knielsen/pcb_pov3d/README

PCB for 3D POV based on STM32F405 MCU and TLC5955 LED driver.
