knielsen/pcb_pov3d/pcb_pov3d.kicad_pcb

## KiCad design pcb_pov3d.kicad_pcb (2015-05-03)

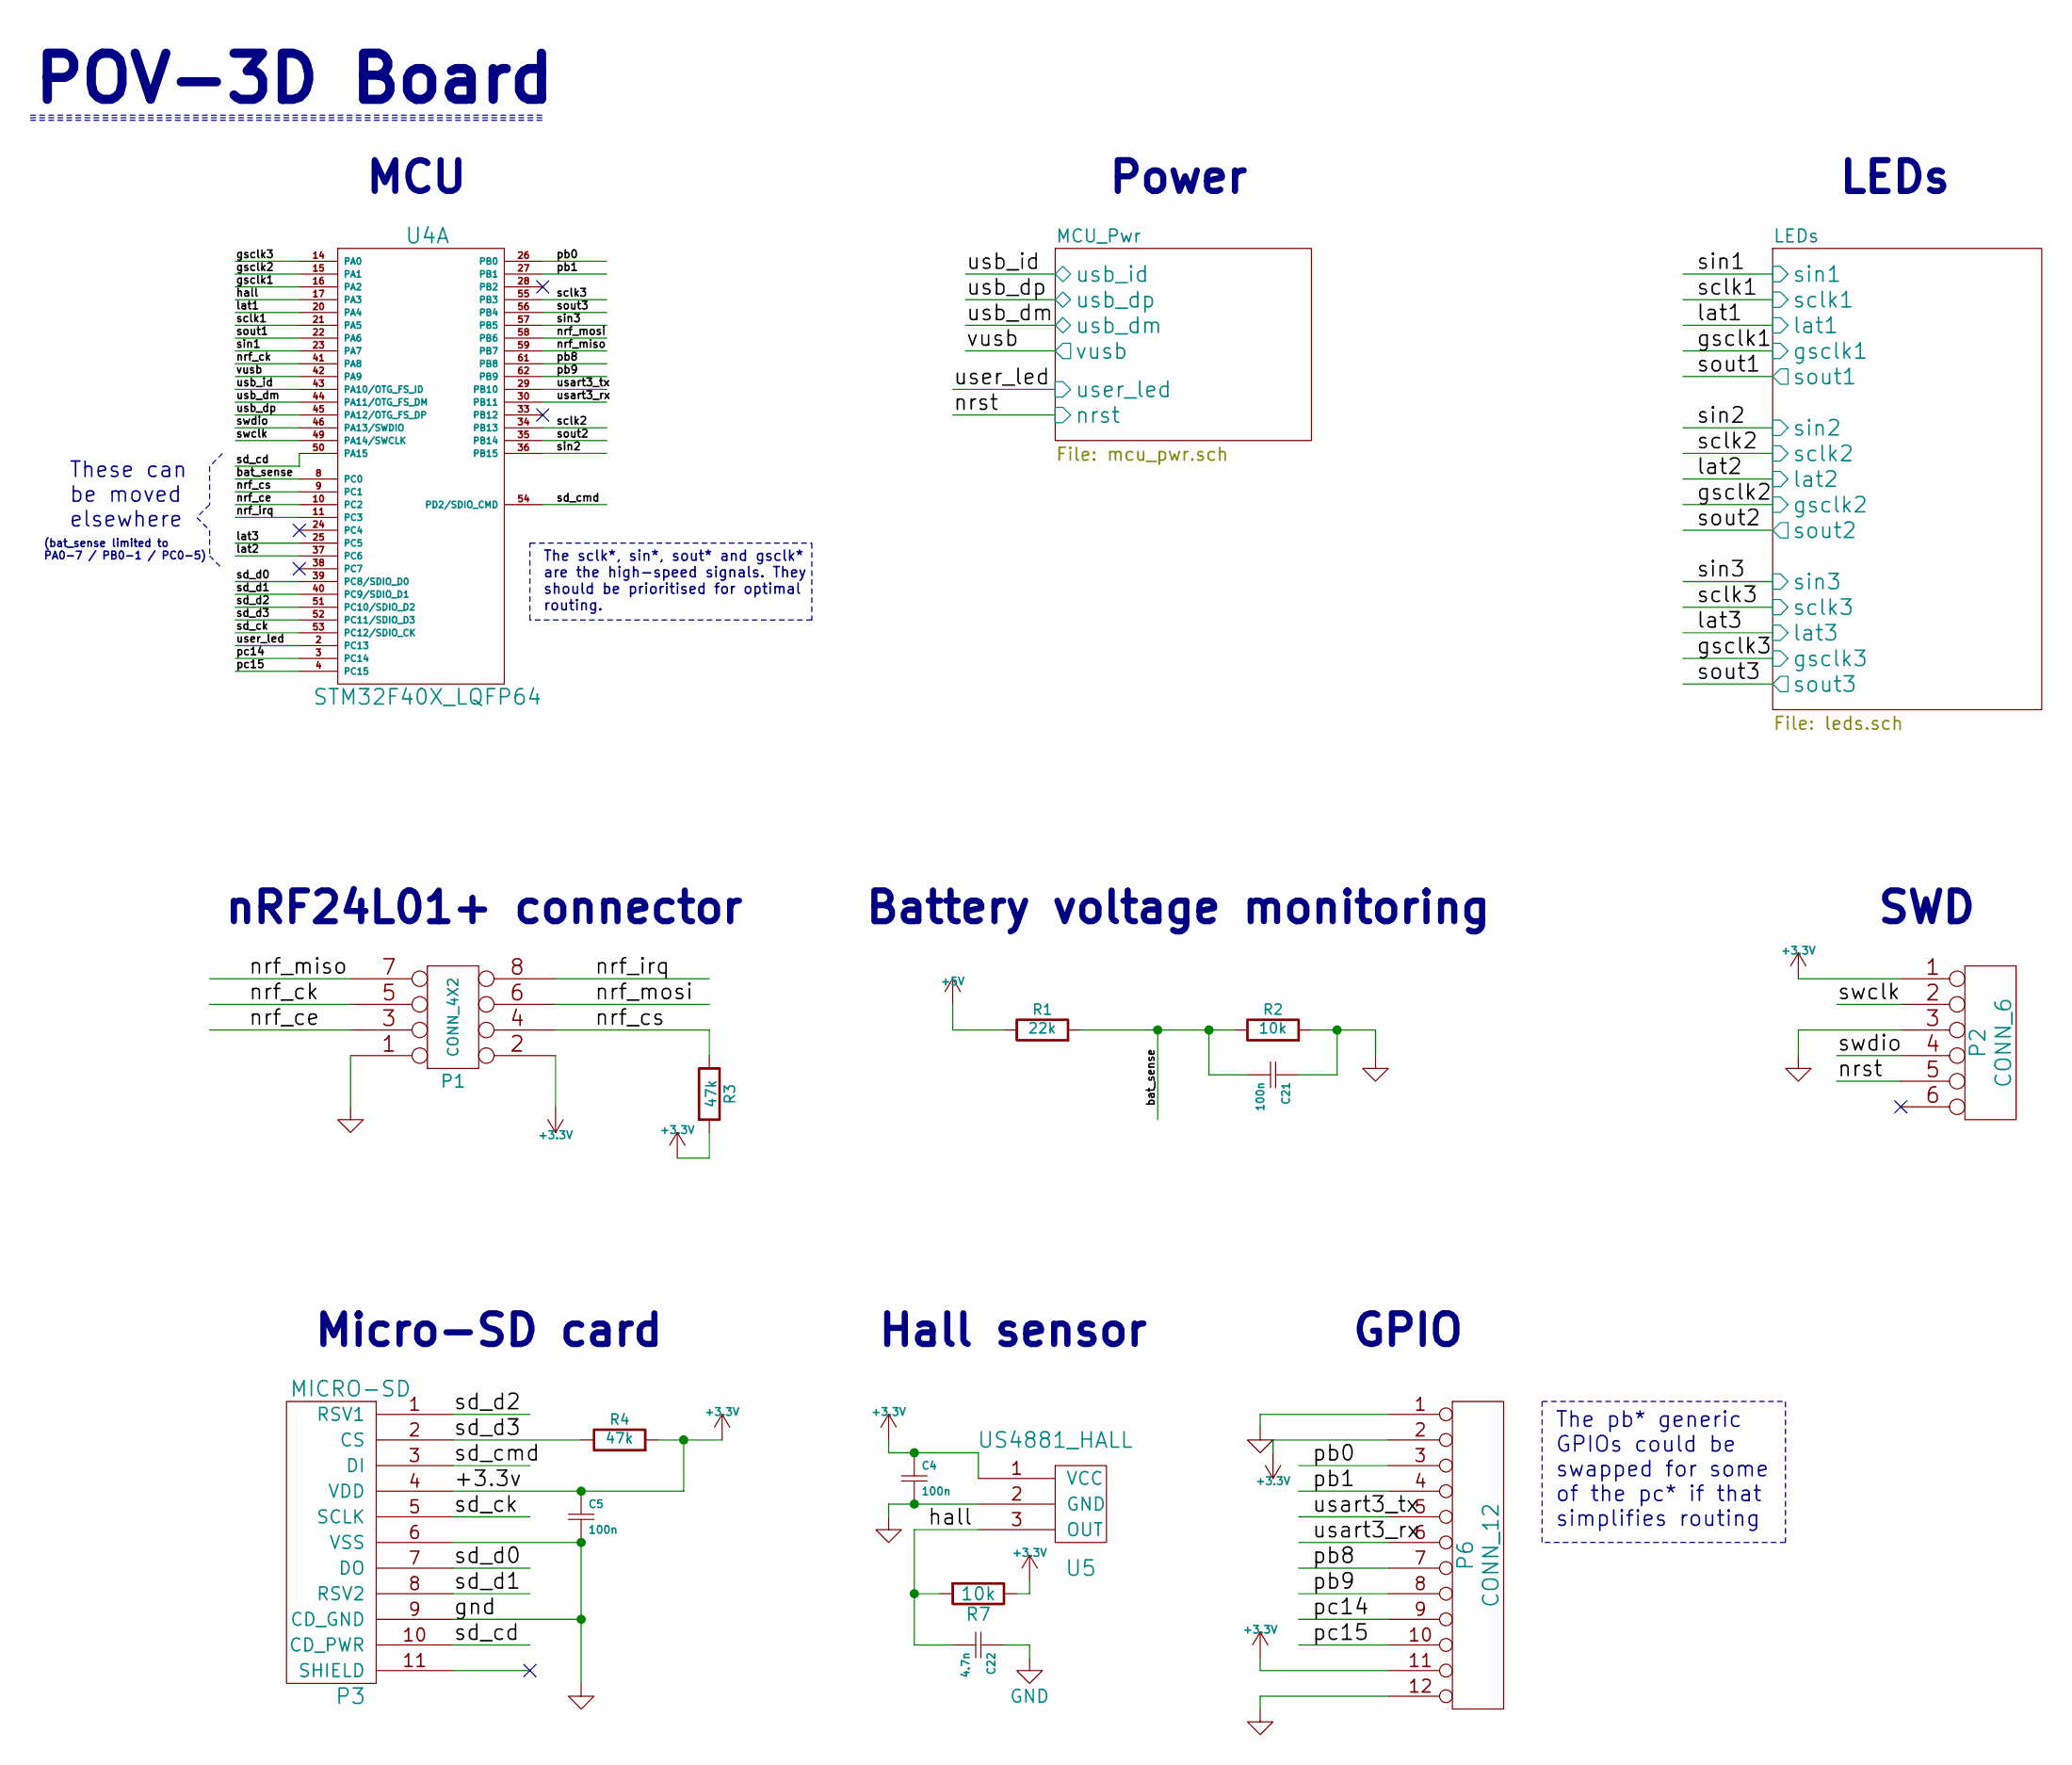
[picture p1: schematic pcb_pov3d.sch]

Parts:
C4, C5, C21: 100n; c_0805
C22: 4.7n; c_0805
P1: CONN_4X2; pin_socket_4x2
P2: CONN_6; pin_strip_6
P3: MICRO-SD; SD_502774
P6: CONN_12; pin_strip_12-90
R1: 22k; r_0805
R2, R7: 10k; r_0805
R3, R4: 47k; r_0805
U4: STM32F40X_LQFP64; LQFP_64
U5: US4881_HALL; TO92

Connections:
+3V3: C4.1, C5.1, P1.2, P2.1, P3.4 (VDD), P6.2, P6.11, R3.2, R4.2, R7.1, U5.1 (VCC); also elsewhere on the board
+5V: R1.1; also elsewhere on the board
/LEDs/gsclk1: U4.16 (PA2); also elsewhere on the board
/LEDs/gsclk2: U4.15 (PA1); also elsewhere on the board
/LEDs/gsclk3: U4.14 (PA0); also elsewhere on the board
/LEDs/lat1: U4.20 (PA4); also elsewhere on the board
/LEDs/lat2: U4.37 (PC6); also elsewhere on the board
/LEDs/lat3: U4.25 (PC5); also elsewhere on the board
/LEDs/sclk1: U4.21 (PA5); also elsewhere on the board
/LEDs/sclk2: U4.34 (PB13); also elsewhere on the board
/LEDs/sclk3: U4.55 (PB3); also elsewhere on the board
/LEDs/sin1: U4.23 (PA7); also elsewhere on the board
/LEDs/sin2: U4.36 (PB15); also elsewhere on the board
/LEDs/sin3: U4.57 (PB5); also elsewhere on the board
/LEDs/sout1: U4.22 (PA6); also elsewhere on the board
/LEDs/sout2: U4.35 (PB14); also elsewhere on the board
/LEDs/sout3: U4.56 (PB4); also elsewhere on the board
/MCU_Pwr/nrst: P2.5; also elsewhere on the board
/MCU_Pwr/usb_dm: U4.44 (PA11/OTG_FS_DM); also elsewhere on the board
/MCU_Pwr/usb_dp: U4.45 (PA12/OTG_FS_DP); also elsewhere on the board
/MCU_Pwr/usb_id: U4.43 (PA10/OTG_FS_ID); also elsewhere on the board
/MCU_Pwr/user_led: U4.2 (PC13); also elsewhere on the board
/MCU_Pwr/vusb: U4.42 (PA9); also elsewhere on the board
/bat_sense: C21.2, R1.2, R2.1, U4.8 (PC0)
/hall: C22.2, R7.2, U4.17 (PA3), U5.3 (OUT)
/nrf_ce: P1.3, U4.10 (PC2)
/nrf_ck: P1.5, U4.41 (PA8)
/nrf_cs: P1.4, R3.1, U4.9 (PC1)
/nrf_irq: P1.8, U4.11 (PC3)
/nrf_miso: P1.7, U4.59 (PB7)
/nrf_mosi: P1.6, U4.58 (PB6)
/pb0: P6.3, U4.26 (PB0)
/pb1: P6.4, U4.27 (PB1)
/pb8: P6.7, U4.61 (PB8)
/pb9: P6.8, U4.62 (PB9)
/pc14: P6.9, U4.3 (PC14)
/pc15: P6.10, U4.4 (PC15)
/sd_cd: P3.10 (CD_PWR), U4.50 (PA15)
/sd_ck: P3.5 (SCLK), U4.53 (PC12/SDIO_CK)
/sd_cmd: P3.3 (DI), U4.54 (PD2/SDIO_CMD)
/sd_d0: P3.7 (DO), U4.39 (PC8/SDIO_D0)
/sd_d1: P3.8 (RSV2), U4.40 (PC9/SDIO_D1)
/sd_d2: P3.1 (RSV1), U4.51 (PC10/SDIO_D2)
/sd_d3: P3.2 (CS), R4.1, U4.52 (PC11/SDIO_D3)
/swclk: P2.2, U4.49 (PA14/SWCLK)
/swdio: P2.4, U4.46 (PA13/SWDIO)
/usart3_rx: P6.6, U4.30 (PB11)
/usart3_tx: P6.5, U4.29 (PB10)
GND: C4.2, C5.2, C21.1, C22.1, P1.1, P2.3, P3.6 (VSS), P3.9 (CD_GND), P6.1, P6.12, R2.2, U5.2 (GND); also elsewhere on the board

Notes on the sheet:
nRF24L01+ connector
MCU
Micro-SD card
These can be moved elsewhere
(bat_sense limited to PA0-7 / PB0-1 / PC0-5)
Battery voltage monitoring
Power
LEDs
SWD
Hall sensor
GPIO
POV-3D Board
The sclk*, sin*, sout* and gsclk* are the high-speed signals. They should be prioritised for optimal routing.
The pb* generic GPIOs could be swapped for some of the pc* if that simplifies routing

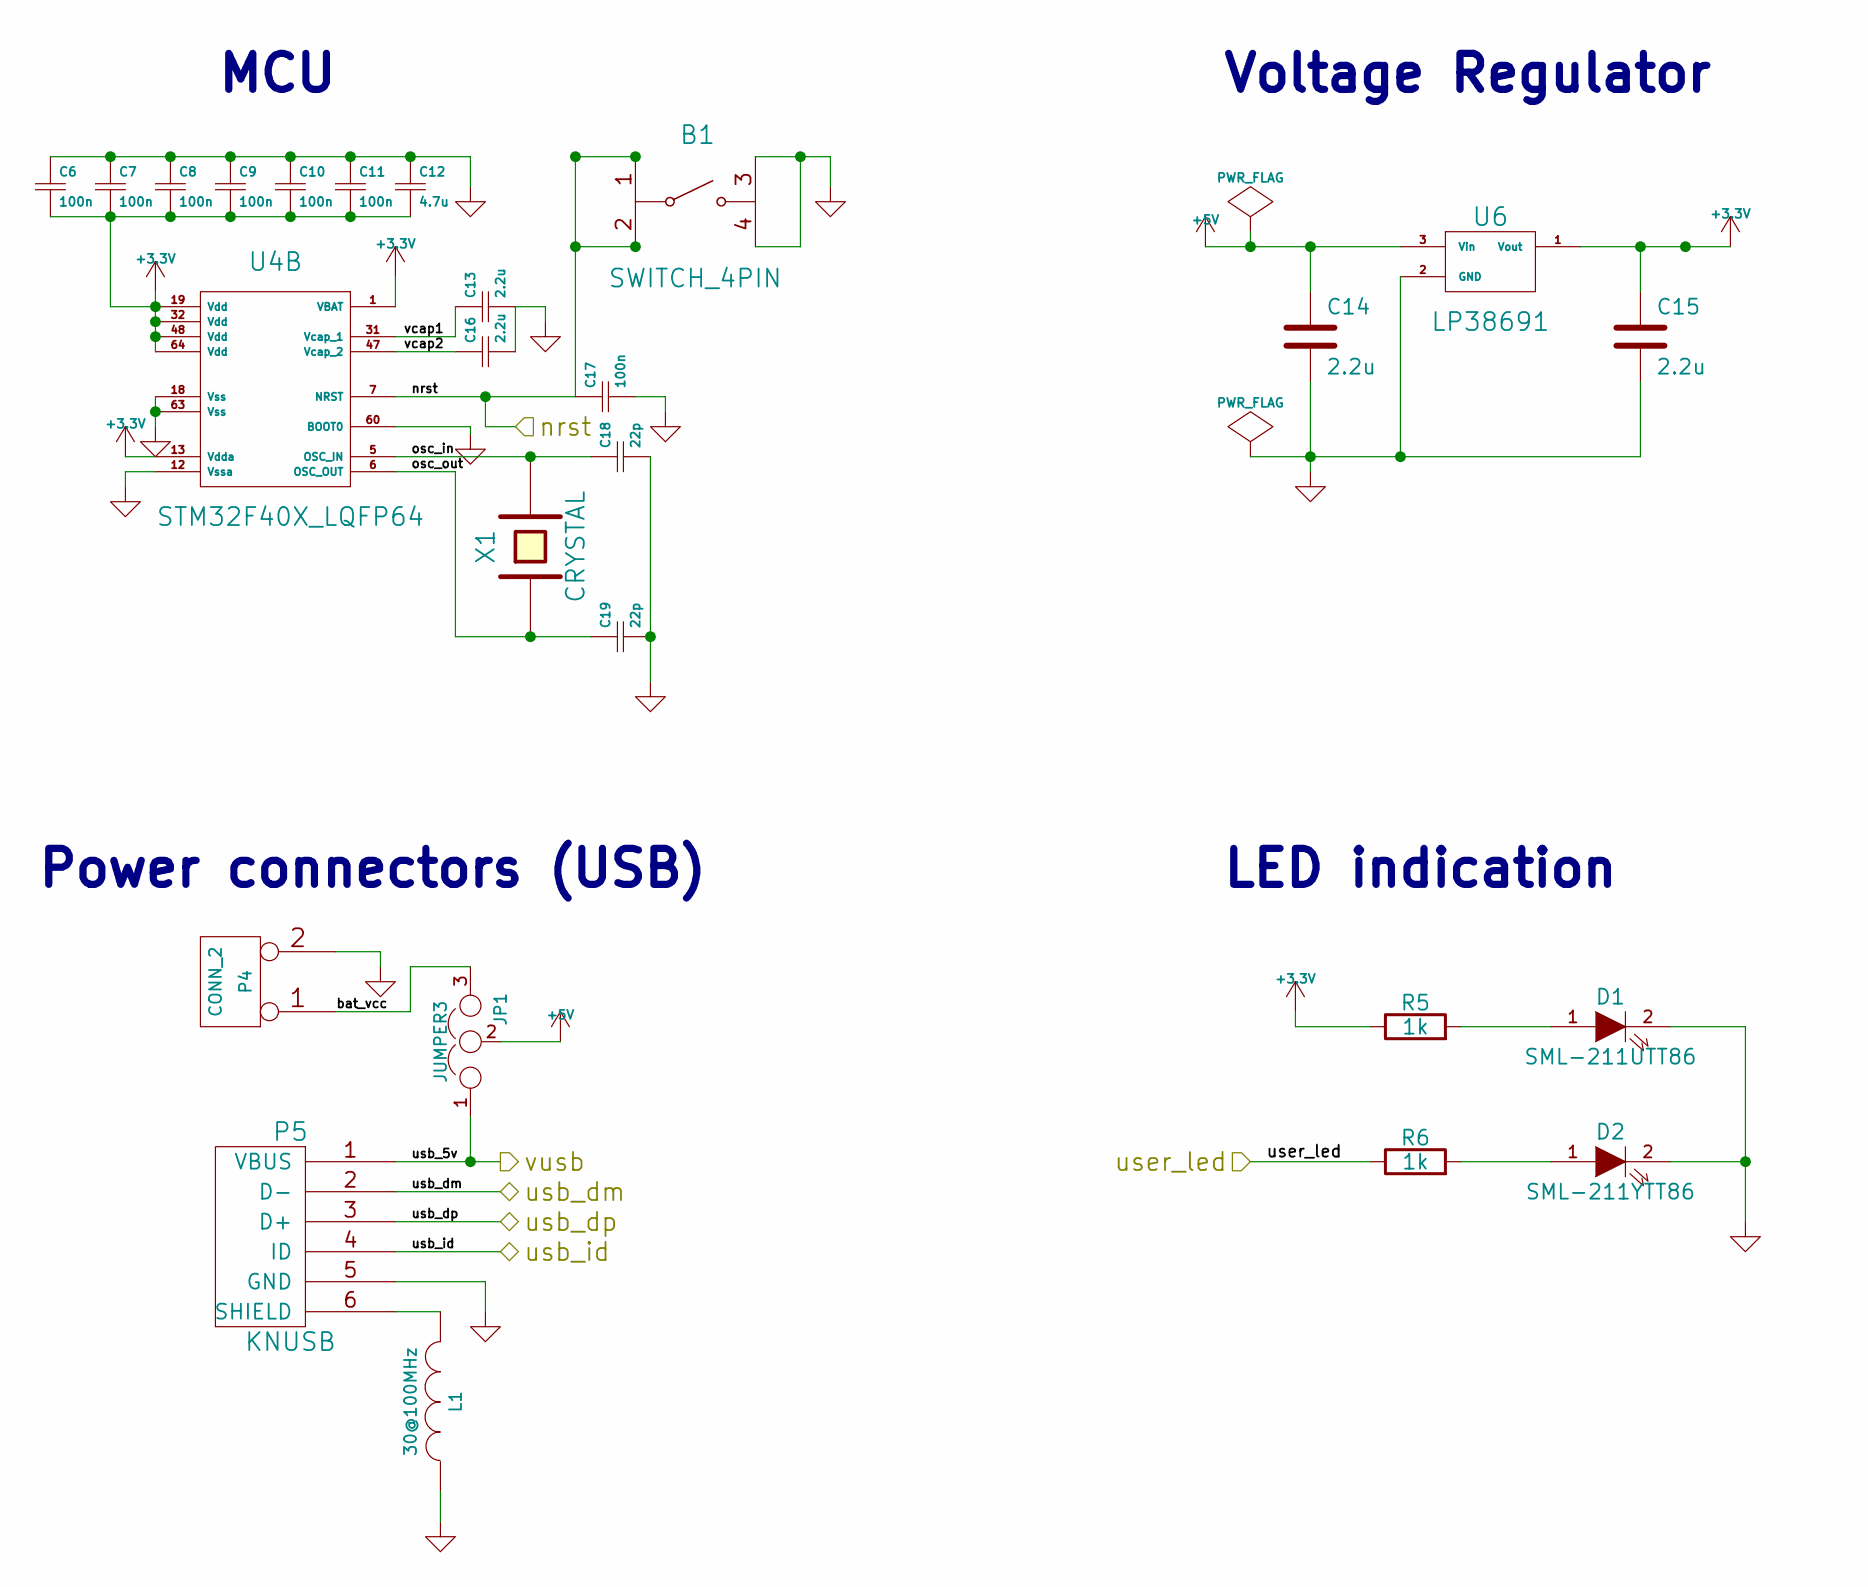
[picture p2: schematic mcu_pwr.sch]

Parts:
B1: SWITCH_4PIN; SWITCH_FSMJSMA
C6, C7, C8, C9, C10, C11, C17: 100n; c_0805
C12: 4.7u; c_0805
C13, C14, C15, C16: 2.2u; c_0805
C18, C19: 22p; c_0805
D1: SML-211UTT86; Led_0805
D2: SML-211YTT86; Led_0805
JP1: JUMPER3; pin_strip_3
L1: 30@100MHz; SMD-0603
P4: CONN_2; pin_strip_2-90
P5: KNUSB; 10103594-0001LF
R5, R6: 1k; r_0805
U4: STM32F40X_LQFP64; LQFP_64
U6: LP38691; TO-252-3
X1: CRYSTAL; 2-SOJ

Connections:
+3V3: C6.2, C7.2, C8.2, C9.2, C10.2, C11.2, C12.2, C15.1, R5.1, U4.1 (VBAT), U4.13 (Vdda), U4.19 (Vdd), U4.32 (Vdd), U4.48 (Vdd), U4.64 (Vdd), U6.1 (Vout); also elsewhere on the board
+5V: C14.1, JP1.2, U6.3 (Vin); also elsewhere on the board
/MCU_Pwr/bat_vcc: JP1.3, P4.1
/MCU_Pwr/nrst: B1.1, B1.2, C17.1, U4.7 (NRST); also elsewhere on the board
/MCU_Pwr/osc_in: C18.1, U4.5 (OSC_IN), X1.2
/MCU_Pwr/osc_out: C19.1, U4.6 (OSC_OUT), X1.1
/MCU_Pwr/usb_dm: P5.2 (D-); also elsewhere on the board
/MCU_Pwr/usb_dp: P5.3 (D+); also elsewhere on the board
/MCU_Pwr/usb_id: P5.4 (ID); also elsewhere on the board
/MCU_Pwr/user_led: R6.1; also elsewhere on the board
/MCU_Pwr/vcap1: C13.1, U4.31 (Vcap_1)
/MCU_Pwr/vcap2: C16.1, U4.47 (Vcap_2)
/MCU_Pwr/vusb: JP1.1, P5.1 (VBUS); also elsewhere on the board
GND: B1.3, B1.4, C6.1, C7.1, C8.1, C9.1, C10.1, C11.1, C12.1, C13.2, C14.2, C15.2, C16.2, C17.2, C18.2, C19.2, D1.2 (K), D2.2 (K), L1.1, P4.2 (PM), P5.5 (GND), U4.12 (Vssa), U4.18 (Vss), U4.60 (BOOT0), U4.63 (Vss), U6.2 (GND); also elsewhere on the board
unnamed: D1.1 (A), R5.2
unnamed: D2.1 (A), R6.2
unnamed: L1.2, P5.6 (SHIELD)

Notes on the sheet:
MCU
Voltage Regulator
Power connectors (USB)
LED indication

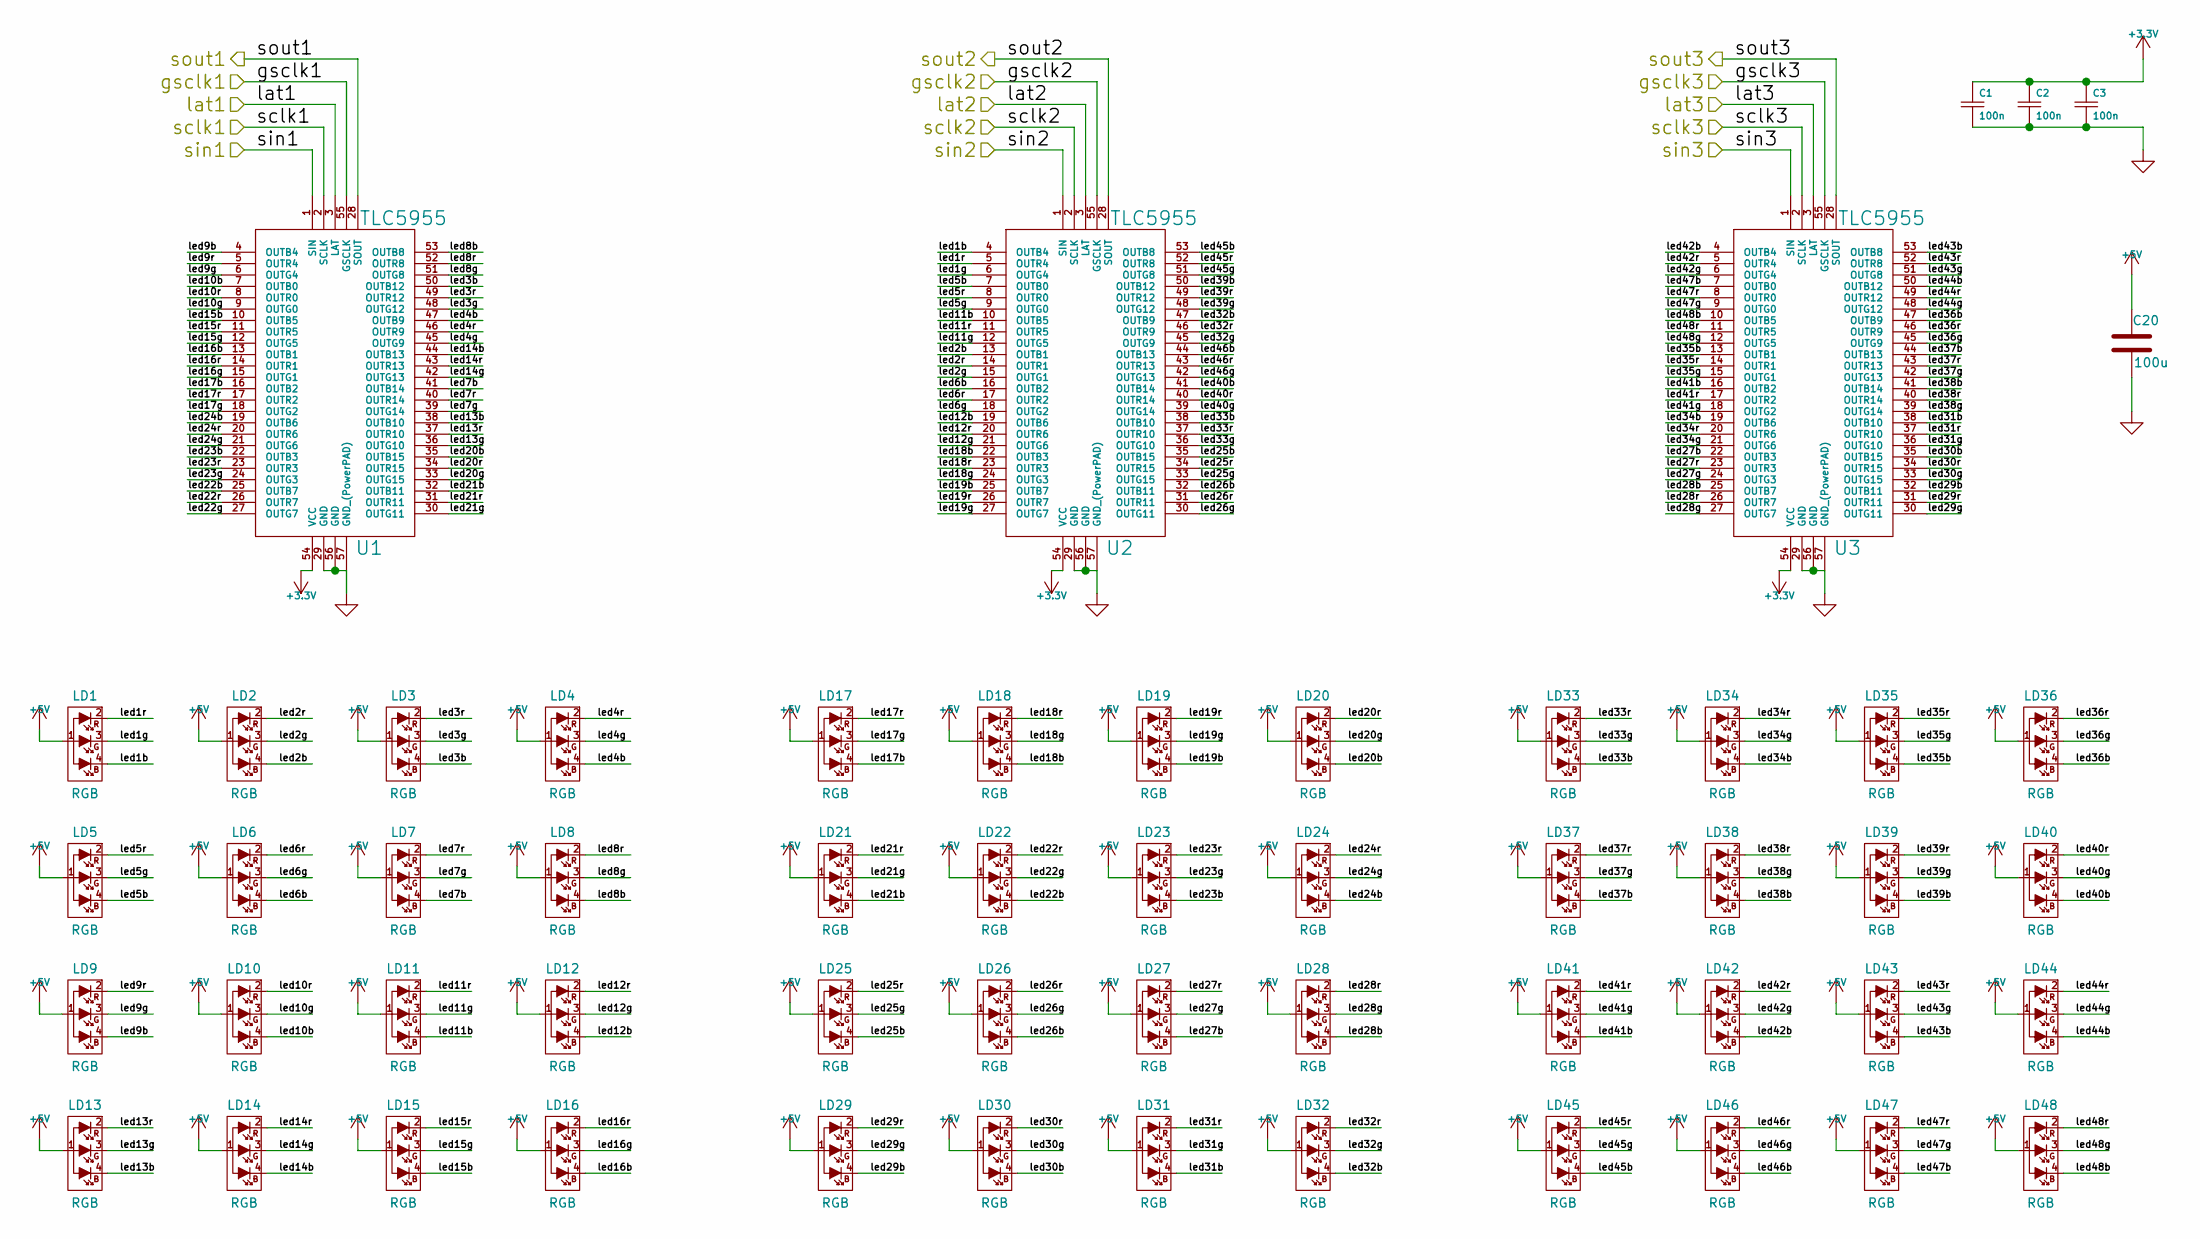
[picture p3: schematic leds.sch]

Parts:
C1, C2, C3: 100n; c_0805
C20: 100u; c_elec_6.3x5.8
LD1, LD2, LD3, LD4, LD5, LD6, LD7, LD8, LD9, LD10, LD11, LD12, LD13, LD14, LD15, LD16, LD17, LD18, LD19, LD20, LD21, LD22, LD23, LD24, LD25, LD26, LD27, LD28, LD29, LD30, LD31, LD32, LD33, LD34, LD35, LD36, LD37, LD38, LD39, LD40, LD41, LD42, LD43, LD44, LD45, LD46, LD47, LD48: RGB; RGB_0603
U1, U2, U3: TLC5955; TLC5955DCA

Connections:
+3V3: C1.1, C2.1, C3.1, U1.54 (VCC), U2.54 (VCC), U3.54 (VCC); also elsewhere on the board
+5V: C20.1, LD1.1 (AG), LD2.1 (AG), LD3.1 (AG), LD4.1 (AG), LD5.1 (AG), LD6.1 (AG), LD7.1 (AG), LD8.1 (AG), LD9.1 (AG), LD10.1 (AG), LD11.1 (AG), LD12.1 (AG), LD13.1 (AG), LD14.1 (AG), LD15.1 (AG), LD16.1 (AG), LD17.1 (AG), LD18.1 (AG), LD19.1 (AG), LD20.1 (AG), LD21.1 (AG), LD22.1 (AG), LD23.1 (AG), LD24.1 (AG), LD25.1 (AG), LD26.1 (AG), LD27.1 (AG), LD28.1 (AG), LD29.1 (AG), LD30.1 (AG), LD31.1 (AG), LD32.1 (AG), LD33.1 (AG), LD34.1 (AG), LD35.1 (AG), LD36.1 (AG), LD37.1 (AG), LD38.1 (AG), LD39.1 (AG), LD40.1 (AG), LD41.1 (AG), LD42.1 (AG), LD43.1 (AG), LD44.1 (AG), LD45.1 (AG), LD46.1 (AG), LD47.1 (AG), LD48.1 (AG); also elsewhere on the board
/LEDs/gsclk1: U1.55 (GSCLK); also elsewhere on the board
/LEDs/gsclk2: U2.55 (GSCLK); also elsewhere on the board
/LEDs/gsclk3: U3.55 (GSCLK); also elsewhere on the board
/LEDs/lat1: U1.3 (LAT); also elsewhere on the board
/LEDs/lat2: U2.3 (LAT); also elsewhere on the board
/LEDs/lat3: U3.3 (LAT); also elsewhere on the board
/LEDs/led1b: LD1.4 (CB), U2.4 (OUTB4)
/LEDs/led1g: LD1.3 (CG), U2.6 (OUTG4)
/LEDs/led1r: LD1.2 (CR), U2.5 (OUTR4)
/LEDs/led2b: LD2.4 (CB), U2.13 (OUTB1)
/LEDs/led2g: LD2.3 (CG), U2.15 (OUTG1)
/LEDs/led2r: LD2.2 (CR), U2.14 (OUTR1)
/LEDs/led3b: LD3.4 (CB), U1.50 (OUTB12)
/LEDs/led3g: LD3.3 (CG), U1.48 (OUTG12)
/LEDs/led3r: LD3.2 (CR), U1.49 (OUTR12)
/LEDs/led4b: LD4.4 (CB), U1.47 (OUTB9)
/LEDs/led4g: LD4.3 (CG), U1.45 (OUTG9)
/LEDs/led4r: LD4.2 (CR), U1.46 (OUTR9)
/LEDs/led5b: LD5.4 (CB), U2.7 (OUTB0)
/LEDs/led5g: LD5.3 (CG), U2.9 (OUTG0)
/LEDs/led5r: LD5.2 (CR), U2.8 (OUTR0)
/LEDs/led6b: LD6.4 (CB), U2.16 (OUTB2)
/LEDs/led6g: LD6.3 (CG), U2.18 (OUTG2)
/LEDs/led6r: LD6.2 (CR), U2.17 (OUTR2)
/LEDs/led7b: LD7.4 (CB), U1.41 (OUTB14)
/LEDs/led7g: LD7.3 (CG), U1.39 (OUTG14)
/LEDs/led7r: LD7.2 (CR), U1.40 (OUTR14)
/LEDs/led8b: LD8.4 (CB), U1.53 (OUTB8)
/LEDs/led8g: LD8.3 (CG), U1.51 (OUTG8)
/LEDs/led8r: LD8.2 (CR), U1.52 (OUTR8)
/LEDs/led9b: LD9.4 (CB), U1.4 (OUTB4)
/LEDs/led9g: LD9.3 (CG), U1.6 (OUTG4)
/LEDs/led9r: LD9.2 (CR), U1.5 (OUTR4)
/LEDs/led10b: LD10.4 (CB), U1.7 (OUTB0)
/LEDs/led10g: LD10.3 (CG), U1.9 (OUTG0)
/LEDs/led10r: LD10.2 (CR), U1.8 (OUTR0)
/LEDs/led11b: LD11.4 (CB), U2.10 (OUTB5)
/LEDs/led11g: LD11.3 (CG), U2.12 (OUTG5)
/LEDs/led11r: LD11.2 (CR), U2.11 (OUTR5)
/LEDs/led12b: LD12.4 (CB), U2.19 (OUTB6)
/LEDs/led12g: LD12.3 (CG), U2.21 (OUTG6)
/LEDs/led12r: LD12.2 (CR), U2.20 (OUTR6)
/LEDs/led13b: LD13.4 (CB), U1.38 (OUTB10)
/LEDs/led13g: LD13.3 (CG), U1.36 (OUTG10)
/LEDs/led13r: LD13.2 (CR), U1.37 (OUTR10)
/LEDs/led14b: LD14.4 (CB), U1.44 (OUTB13)
/LEDs/led14g: LD14.3 (CG), U1.42 (OUTG13)
/LEDs/led14r: LD14.2 (CR), U1.43 (OUTR13)
/LEDs/led15b: LD15.4 (CB), U1.10 (OUTB5)
/LEDs/led15g: LD15.3 (CG), U1.12 (OUTG5)
/LEDs/led15r: LD15.2 (CR), U1.11 (OUTR5)
/LEDs/led16b: LD16.4 (CB), U1.13 (OUTB1)
/LEDs/led16g: LD16.3 (CG), U1.15 (OUTG1)
/LEDs/led16r: LD16.2 (CR), U1.14 (OUTR1)
/LEDs/led17b: LD17.4 (CB), U1.16 (OUTB2)
/LEDs/led17g: LD17.3 (CG), U1.18 (OUTG2)
/LEDs/led17r: LD17.2 (CR), U1.17 (OUTR2)
/LEDs/led18b: LD18.4 (CB), U2.22 (OUTB3)
/LEDs/led18g: LD18.3 (CG), U2.24 (OUTG3)
/LEDs/led18r: LD18.2 (CR), U2.23 (OUTR3)
/LEDs/led19b: LD19.4 (CB), U2.25 (OUTB7)
/LEDs/led19g: LD19.3 (CG), U2.27 (OUTG7)
/LEDs/led19r: LD19.2 (CR), U2.26 (OUTR7)
/LEDs/led20b: LD20.4 (CB), U1.35 (OUTB15)
/LEDs/led20g: LD20.3 (CG), U1.33 (OUTG15)
/LEDs/led20r: LD20.2 (CR), U1.34 (OUTR15)
/LEDs/led21b: LD21.4 (CB), U1.32 (OUTB11)
/LEDs/led21g: LD21.3 (CG), U1.30 (OUTG11)
/LEDs/led21r: LD21.2 (CR), U1.31 (OUTR11)
/LEDs/led22b: LD22.4 (CB), U1.25 (OUTB7)
/LEDs/led22g: LD22.3 (CG), U1.27 (OUTG7)
/LEDs/led22r: LD22.2 (CR), U1.26 (OUTR7)
/LEDs/led23b: LD23.4 (CB), U1.22 (OUTB3)
/LEDs/led23g: LD23.3 (CG), U1.24 (OUTG3)
/LEDs/led23r: LD23.2 (CR), U1.23 (OUTR3)
/LEDs/led24b: LD24.4 (CB), U1.19 (OUTB6)
/LEDs/led24g: LD24.3 (CG), U1.21 (OUTG6)
/LEDs/led24r: LD24.2 (CR), U1.20 (OUTR6)
/LEDs/led25b: LD25.4 (CB), U2.35 (OUTB15)
/LEDs/led25g: LD25.3 (CG), U2.33 (OUTG15)
/LEDs/led25r: LD25.2 (CR), U2.34 (OUTR15)
/LEDs/led26b: LD26.4 (CB), U2.32 (OUTB11)
/LEDs/led26g: LD26.3 (CG), U2.30 (OUTG11)
/LEDs/led26r: LD26.2 (CR), U2.31 (OUTR11)
/LEDs/led27b: LD27.4 (CB), U3.22 (OUTB3)
/LEDs/led27g: LD27.3 (CG), U3.24 (OUTG3)
/LEDs/led27r: LD27.2 (CR), U3.23 (OUTR3)
/LEDs/led28b: LD28.4 (CB), U3.25 (OUTB7)
/LEDs/led28g: LD28.3 (CG), U3.27 (OUTG7)
/LEDs/led28r: LD28.2 (CR), U3.26 (OUTR7)
/LEDs/led29b: LD29.4 (CB), U3.32 (OUTB11)
/LEDs/led29g: LD29.3 (CG), U3.30 (OUTG11)
/LEDs/led29r: LD29.2 (CR), U3.31 (OUTR11)
/LEDs/led30b: LD30.4 (CB), U3.35 (OUTB15)
/LEDs/led30g: LD30.3 (CG), U3.33 (OUTG15)
/LEDs/led30r: LD30.2 (CR), U3.34 (OUTR15)
/LEDs/led31b: LD31.4 (CB), U3.38 (OUTB10)
/LEDs/led31g: LD31.3 (CG), U3.36 (OUTG10)
/LEDs/led31r: LD31.2 (CR), U3.37 (OUTR10)
/LEDs/led32b: LD32.4 (CB), U2.47 (OUTB9)
/LEDs/led32g: LD32.3 (CG), U2.45 (OUTG9)
/LEDs/led32r: LD32.2 (CR), U2.46 (OUTR9)
/LEDs/led33b: LD33.4 (CB), U2.38 (OUTB10)
/LEDs/led33g: LD33.3 (CG), U2.36 (OUTG10)
/LEDs/led33r: LD33.2 (CR), U2.37 (OUTR10)
/LEDs/led34b: LD34.4 (CB), U3.19 (OUTB6)
/LEDs/led34g: LD34.3 (CG), U3.21 (OUTG6)
/LEDs/led34r: LD34.2 (CR), U3.20 (OUTR6)
/LEDs/led35b: LD35.4 (CB), U3.13 (OUTB1)
/LEDs/led35g: LD35.3 (CG), U3.15 (OUTG1)
/LEDs/led35r: LD35.2 (CR), U3.14 (OUTR1)
/LEDs/led36b: LD36.4 (CB), U3.47 (OUTB9)
/LEDs/led36g: LD36.3 (CG), U3.45 (OUTG9)
/LEDs/led36r: LD36.2 (CR), U3.46 (OUTR9)
/LEDs/led37b: LD37.4 (CB), U3.44 (OUTB13)
/LEDs/led37g: LD37.3 (CG), U3.42 (OUTG13)
/LEDs/led37r: LD37.2 (CR), U3.43 (OUTR13)
/LEDs/led38b: LD38.4 (CB), U3.41 (OUTB14)
/LEDs/led38g: LD38.3 (CG), U3.39 (OUTG14)
/LEDs/led38r: LD38.2 (CR), U3.40 (OUTR14)
/LEDs/led39b: LD39.4 (CB), U2.50 (OUTB12)
/LEDs/led39g: LD39.3 (CG), U2.48 (OUTG12)
/LEDs/led39r: LD39.2 (CR), U2.49 (OUTR12)
/LEDs/led40b: LD40.4 (CB), U2.41 (OUTB14)
/LEDs/led40g: LD40.3 (CG), U2.39 (OUTG14)
/LEDs/led40r: LD40.2 (CR), U2.40 (OUTR14)
/LEDs/led41b: LD41.4 (CB), U3.16 (OUTB2)
/LEDs/led41g: LD41.3 (CG), U3.18 (OUTG2)
/LEDs/led41r: LD41.2 (CR), U3.17 (OUTR2)
/LEDs/led42b: LD42.4 (CB), U3.4 (OUTB4)
/LEDs/led42g: LD42.3 (CG), U3.6 (OUTG4)
/LEDs/led42r: LD42.2 (CR), U3.5 (OUTR4)
/LEDs/led43b: LD43.4 (CB), U3.53 (OUTB8)
/LEDs/led43g: LD43.3 (CG), U3.51 (OUTG8)
/LEDs/led43r: LD43.2 (CR), U3.52 (OUTR8)
/LEDs/led44b: LD44.4 (CB), U3.50 (OUTB12)
/LEDs/led44g: LD44.3 (CG), U3.48 (OUTG12)
/LEDs/led44r: LD44.2 (CR), U3.49 (OUTR12)
/LEDs/led45b: LD45.4 (CB), U2.53 (OUTB8)
/LEDs/led45g: LD45.3 (CG), U2.51 (OUTG8)
/LEDs/led45r: LD45.2 (CR), U2.52 (OUTR8)
/LEDs/led46b: LD46.4 (CB), U2.44 (OUTB13)
/LEDs/led46g: LD46.3 (CG), U2.42 (OUTG13)
/LEDs/led46r: LD46.2 (CR), U2.43 (OUTR13)
/LEDs/led47b: LD47.4 (CB), U3.7 (OUTB0)
/LEDs/led47g: LD47.3 (CG), U3.9 (OUTG0)
/LEDs/led47r: LD47.2 (CR), U3.8 (OUTR0)
/LEDs/led48b: LD48.4 (CB), U3.10 (OUTB5)
/LEDs/led48g: LD48.3 (CG), U3.12 (OUTG5)
/LEDs/led48r: LD48.2 (CR), U3.11 (OUTR5)
/LEDs/sclk1: U1.2 (SCLK); also elsewhere on the board
/LEDs/sclk2: U2.2 (SCLK); also elsewhere on the board
/LEDs/sclk3: U3.2 (SCLK); also elsewhere on the board
/LEDs/sin1: U1.1 (SIN); also elsewhere on the board
/LEDs/sin2: U2.1 (SIN); also elsewhere on the board
/LEDs/sin3: U3.1 (SIN); also elsewhere on the board
/LEDs/sout1: U1.28 (SOUT); also elsewhere on the board
/LEDs/sout2: U2.28 (SOUT); also elsewhere on the board
/LEDs/sout3: U3.28 (SOUT); also elsewhere on the board
GND: C1.2, C2.2, C3.2, C20.2, U1.29 (GND), U1.56 (GND), U1.57 (GND_(PowerPAD)), U2.29 (GND), U2.56 (GND), U2.57 (GND_(PowerPAD)), U3.29 (GND), U3.56 (GND), U3.57 (GND_(PowerPAD)); also elsewhere on the board

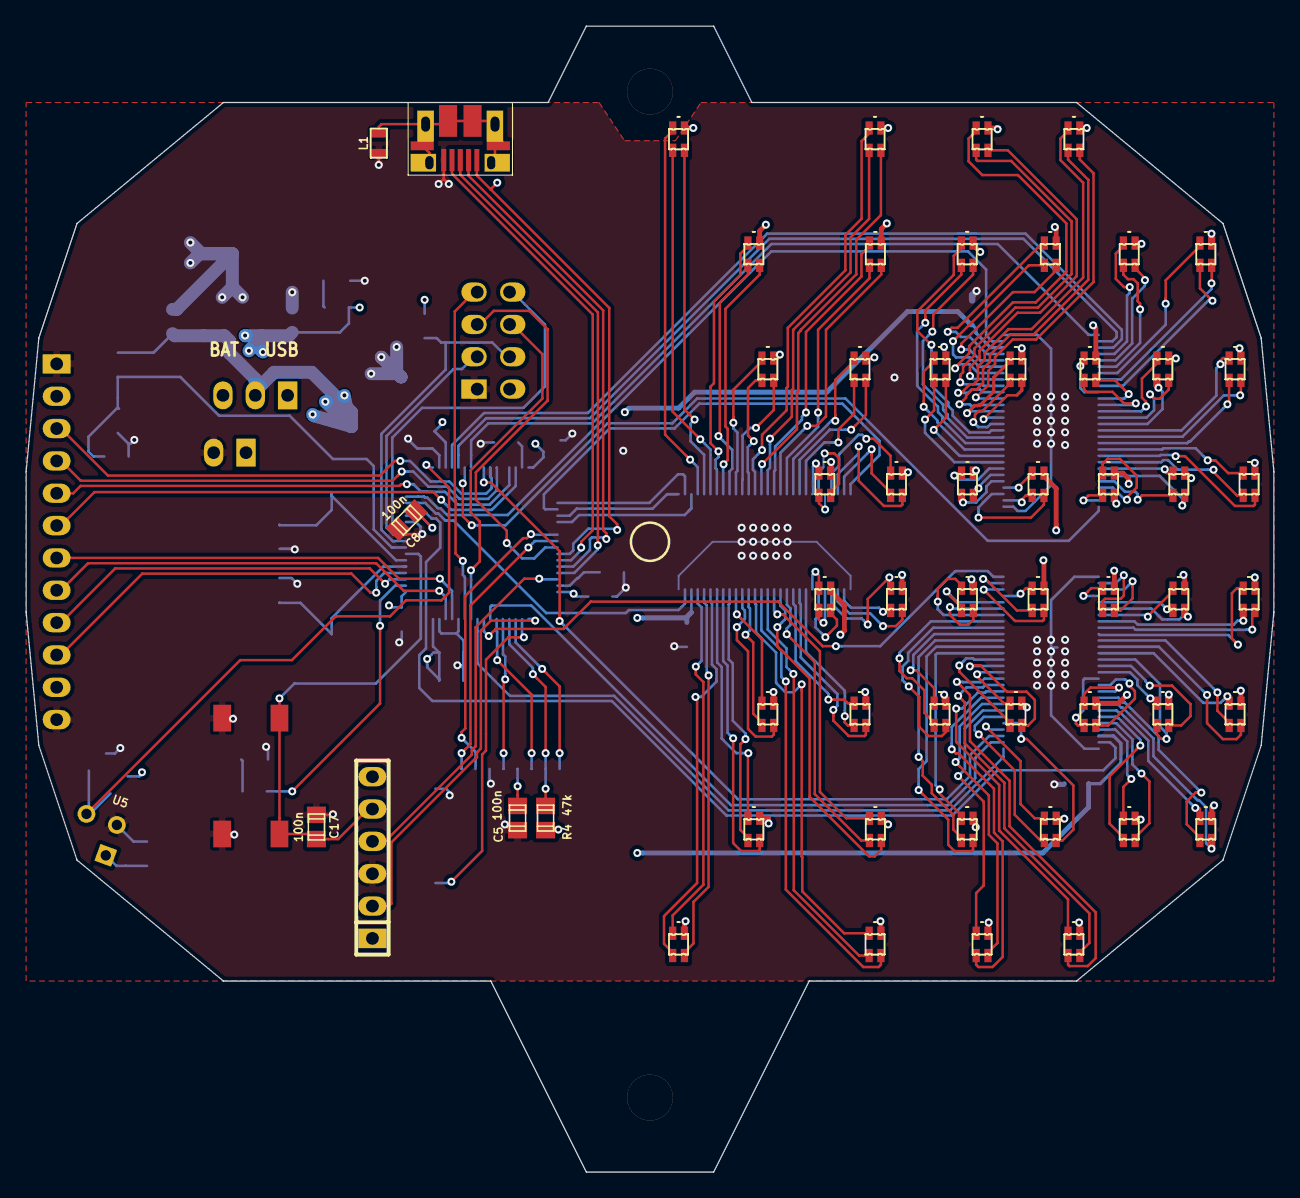
[picture p4: board pcb_pov3d.kicad_pcb from above]

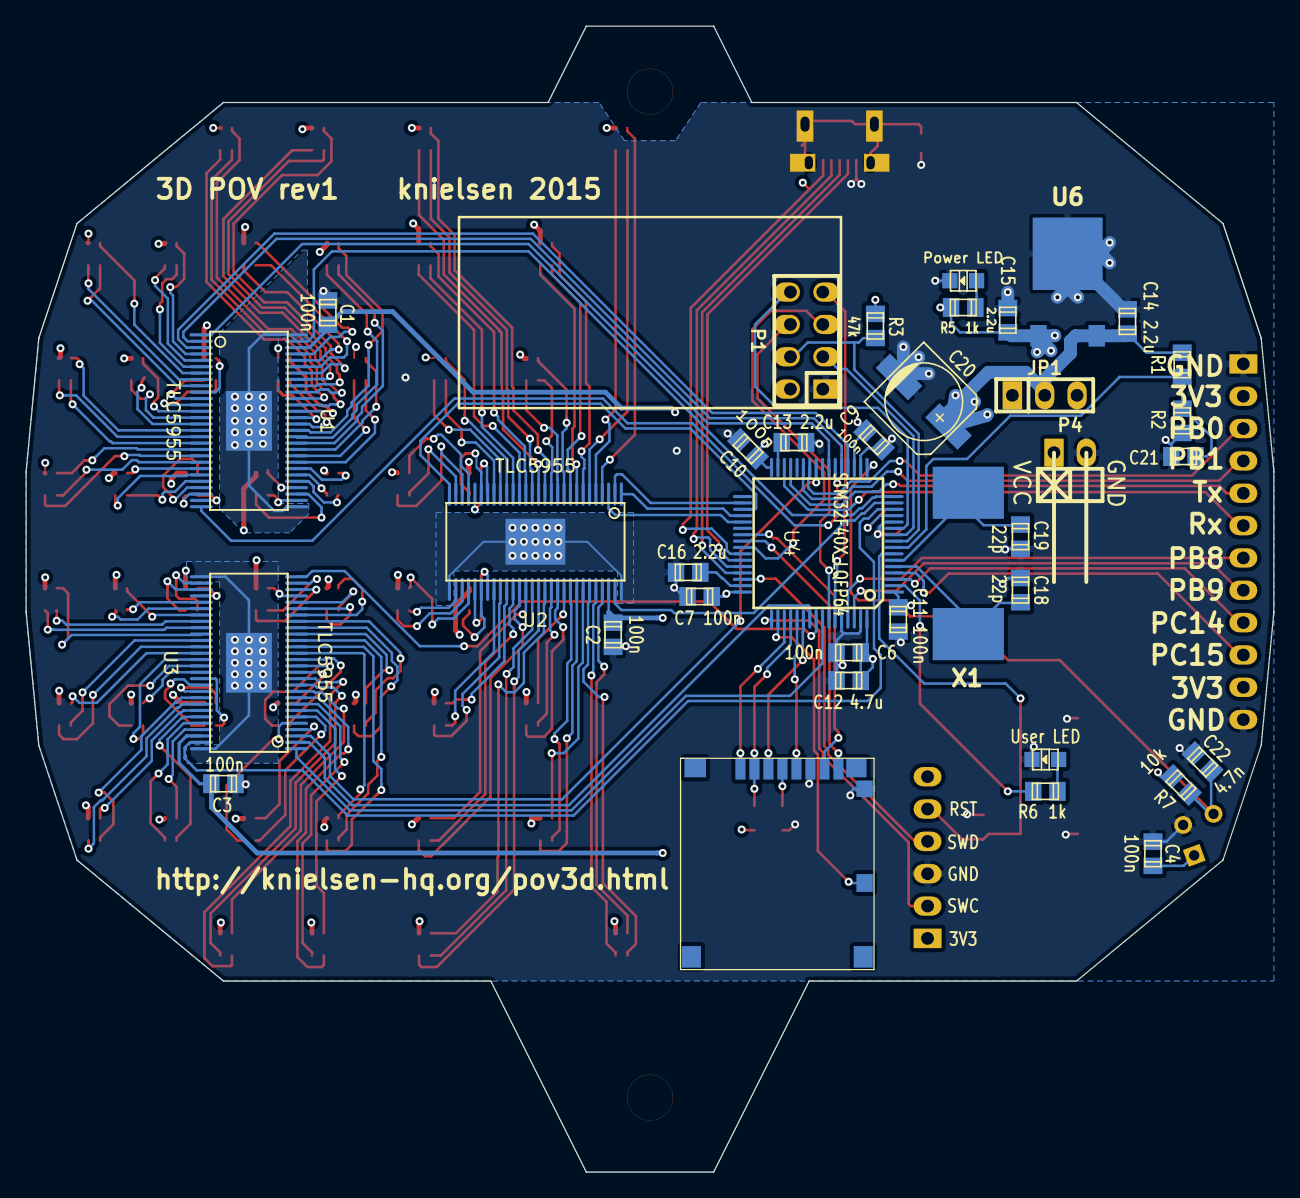
[picture p5: board pcb_pov3d.kicad_pcb from below]

Board: 4 copper layers, 98.0 x 90.0 mm, 95 parts (37 on the bottom side), 201 nets.
