knielsen/pcb_pov3d/(commit log)

2015-01-10 Add tlc5955 powerpad to schematics
    [leds.sch, mcu_pwr.sch, pcb_pov3d.sch]
2015-01-11 Misc. tweaks. Schematics is getting closer now.
    [leds.sch, mcu_pwr.sch, pcb_pov3d.sch]
2015-01-28 Updated for new KiCAD version (though still a few glitches in the schematics)
    [leds.sch, mcu_pwr.sch, pcb_pov3d.kicad_pcb, pcb_pov3d.sch]
2015-01-28 Fix CSMALL <-> Csmall glitch when converting to new version
    [leds.sch, mcu_pwr.sch, pcb_pov3d.sch]
2015-01-28 Fix offset on multi-line texts after import to new KiCAD version.
    [pcb_pov3d.sch]
2015-01-28 Place RGB LEDs in the computed pattern for 3D POV effect.
    [pcb_pov3d.kicad_pcb]
2015-01-29 Assignment of LEDs to TLC5955 outputs.
    [leds.sch, pcb_pov3d.kicad_pcb]
2015-01-29 Powerpads on TLC5955's, and sketch of high-speed signals routing.
    [pcb_pov3d.kicad_pcb, pcb_pov3d.sch]
2015-01-30 LED routing, and initial placement of most remaining components.
    [leds.sch, mcu_pwr.sch, pcb_pov3d.kicad_pcb, pcb_pov3d.sch]
2015-02-03 Most signals routed (still some power/gnd to route)
    [pcb_pov3d.kicad_pcb, pcb_pov3d.sch]
2015-02-03 Complete routing
    [leds.sch, mcu_pwr.sch, pcb_pov3d.kicad_pcb, pcb_pov3d.sch]
2015-02-03 Routing tweaks.
    [pcb_pov3d.kicad_pcb]
2015-02-16 Misc. changes.
    [pcb_pov3d.kicad_pcb]
2015-04-15 fix one 3d shape for new kicad
    [pcb_pov3d.kicad_pcb]
2015-04-15 Fix remaining 3d-shapes for new kicad.
    [pcb_pov3d.kicad_pcb]
2015-04-27 Fixup some missing wires after kicad upgrade
    (A resistor and a capacitor component now has shorter leads, it seems.
    [leds.sch, mcu_pwr.sch, pcb_pov3d.sch]
2015-04-29 Mounting holes - need some work, too close to LED.
    [pcb_pov3d.kicad_pcb]
2015-04-30 Improved mounting holes.
    [pcb_pov3d.kicad_pcb]
2015-05-01 Move 2 TLCs 4mm to not conflict with spindle mount rim
    [leds.sch, pcb_pov3d.kicad_pcb]
2015-05-02 Misc. cleanup of the routing.
    [pcb_pov3d.kicad_pcb]
2015-05-02 Move power connector and jumper away from rim of spindle_mount
    [pcb_pov3d.kicad_pcb]
2015-05-02 Move programmer connector away from rim of spindle_mount
    [pcb_pov3d.kicad_pcb]
2015-05-02 Clean up mounting hole silkscreens.
    [pcb_pov3d.kicad_pcb]
2015-05-02 Silkscreen tweaks.
    [pcb_pov3d.kicad_pcb]
2015-05-03 More silkscreen tweaks.
    [pcb_pov3d.kicad_pcb]
2015-05-03 More silk screen. Should be fairly close now.
    [pcb_pov3d.kicad_pcb]
2015-05-03 One more silk screen update
    [pcb_pov3d.kicad_pcb]
2015-05-03 Add pull-up and capacitor on Hall output
    [leds.sch, mcu_pwr.sch, pcb_pov3d.kicad_pcb, pcb_pov3d.sch]
2015-05-03 Misc. minor tweaks
    [pcb_pov3d.kicad_pcb]
2015-05-06 Final rev1 gerbers ordered from SeeedStudio.
    [pcb_pov3d-B_Cu.gbl, pcb_pov3d-B_Mask.gbs, pcb_pov3d-B_SilkS.gbo, pcb_pov3d-F_Cu.gtl, pcb_pov3d-F_Mask.gts, pcb_pov3d-F_SilkS.gto]
